codeshelf/KW2CPU.PCB/README.md

KW2CPU.PCB
==========

KW2 radio / CPU PCB design files (with production files). "Brain"
