codeshelf/KW2CPU.PCB/KW2CPU.PCB Design Files/EagleUp/eagleUp_KW2CPU.PCB_board_top.jpg

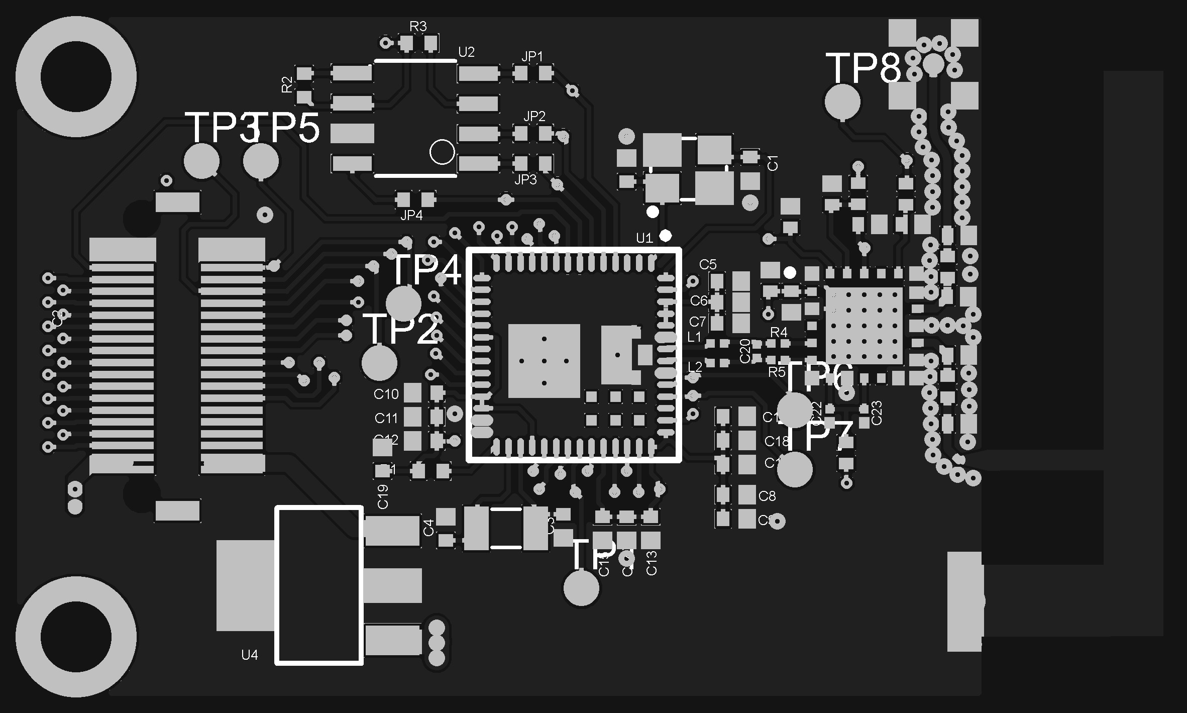
KW2CPU.PCB Design Files/EagleUp/eagleUp_KW2CPU.PCB_board_top.jpg
