codeshelf/KW2CPU.PCB/KW2CPU.PCB Design Files/EagleUp/eagleUp_KW2CPU.PCB_top_mask.png

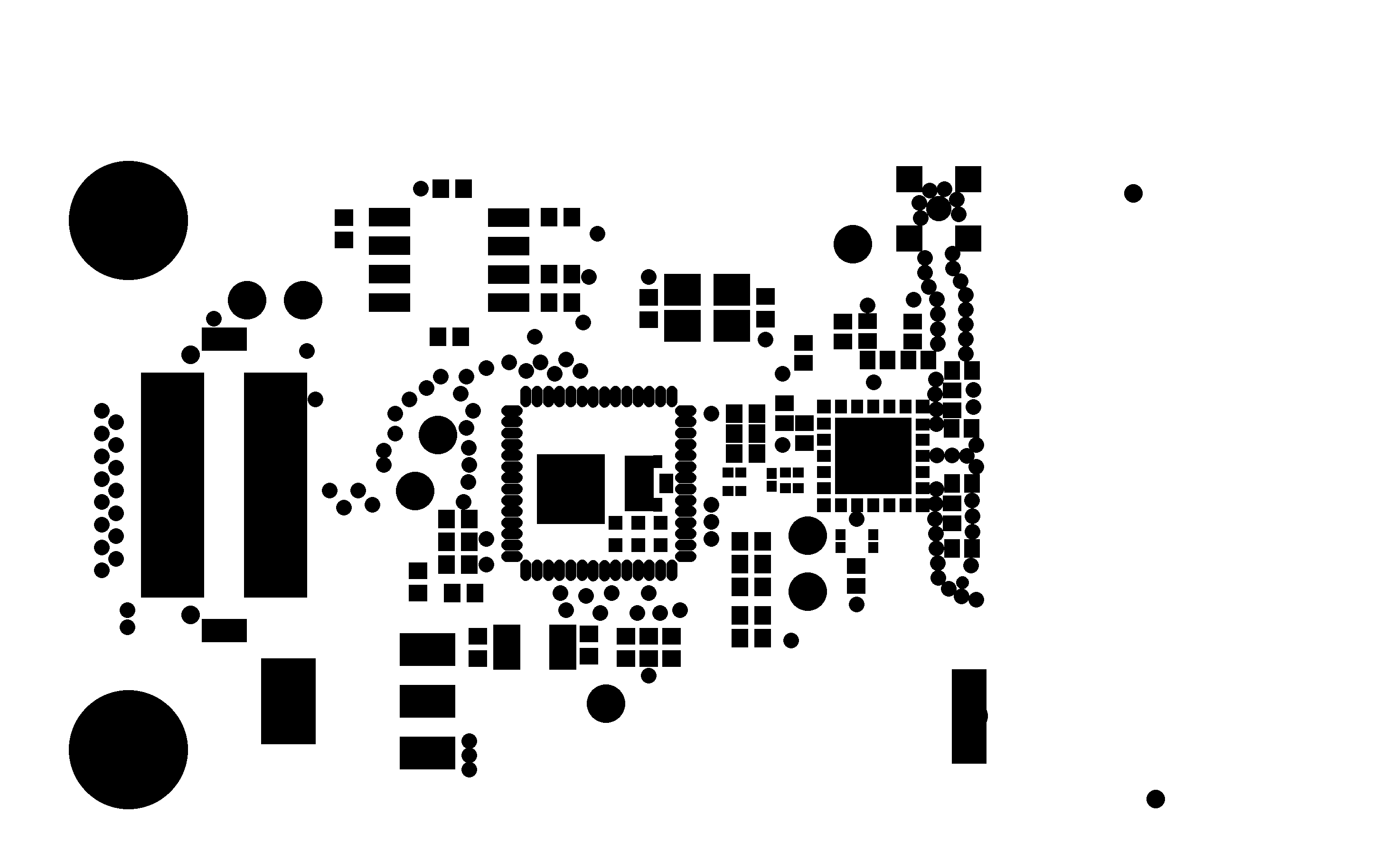
KW2CPU.PCB Design Files/EagleUp/eagleUp_KW2CPU.PCB_top_mask.png
