codeshelf/KW2CPU.PCB/KW2CPU.PCB Design Files/EagleUp/eagleUp_KW2CPU.PCB_top_silk.png

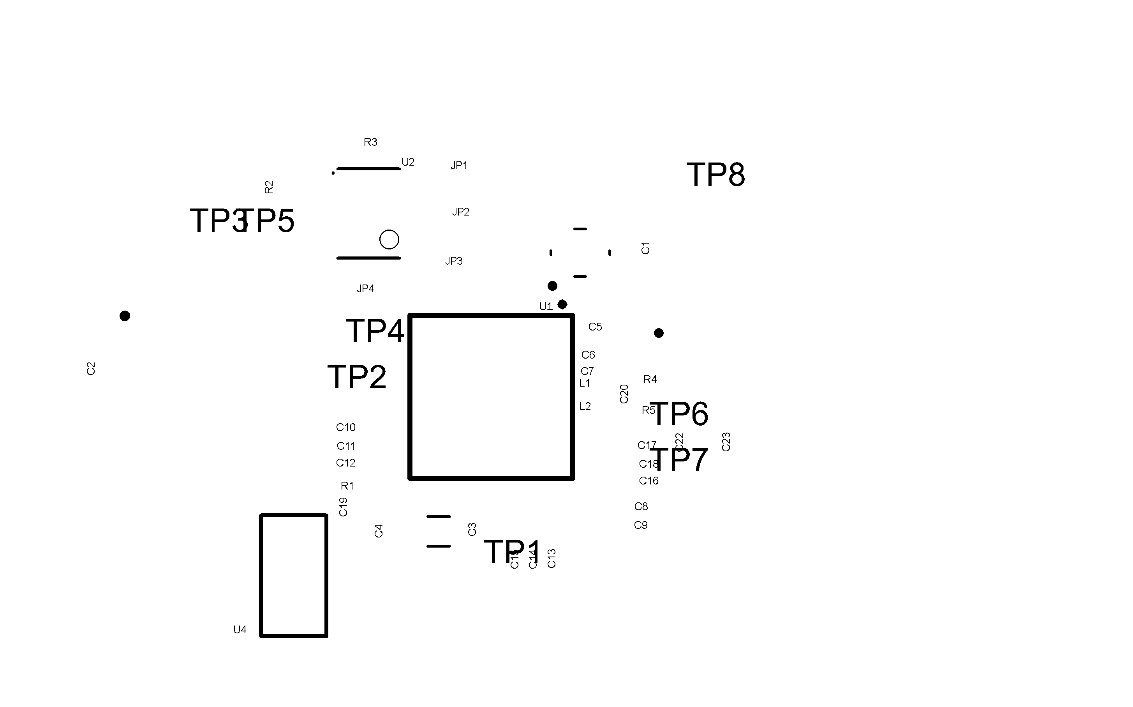
KW2CPU.PCB Design Files/EagleUp/eagleUp_KW2CPU.PCB_top_silk.png
