codeshelf/KW2CPU.PCB/KW2CPU.PCB Design Files/KW2CPU.PCB.dxf

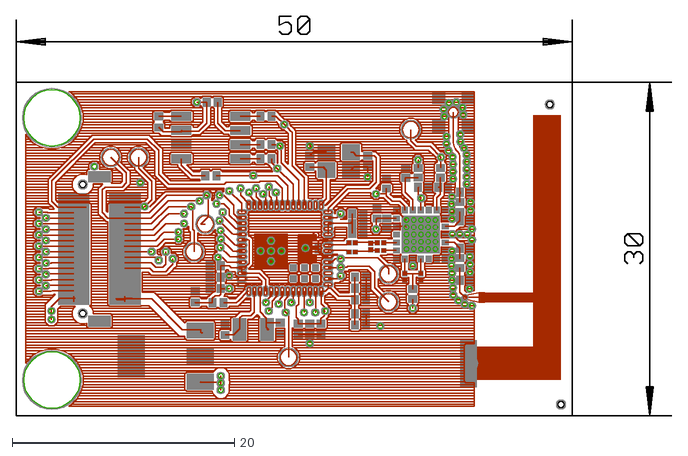
[picture p11: CAD file, 2014-11-19]
KW2CPU.PCB Design Files/KW2CPU.PCB.dxf
59.0 x 35.9
