codeshelf/KW2CPU.PCB/KW2CPU.PCB Design Files/KW2CPU.PCB.brd

## EAGLE design KW2CPU.PCB Design Files/KW2CPU.PCB.brd (2015-08-11)

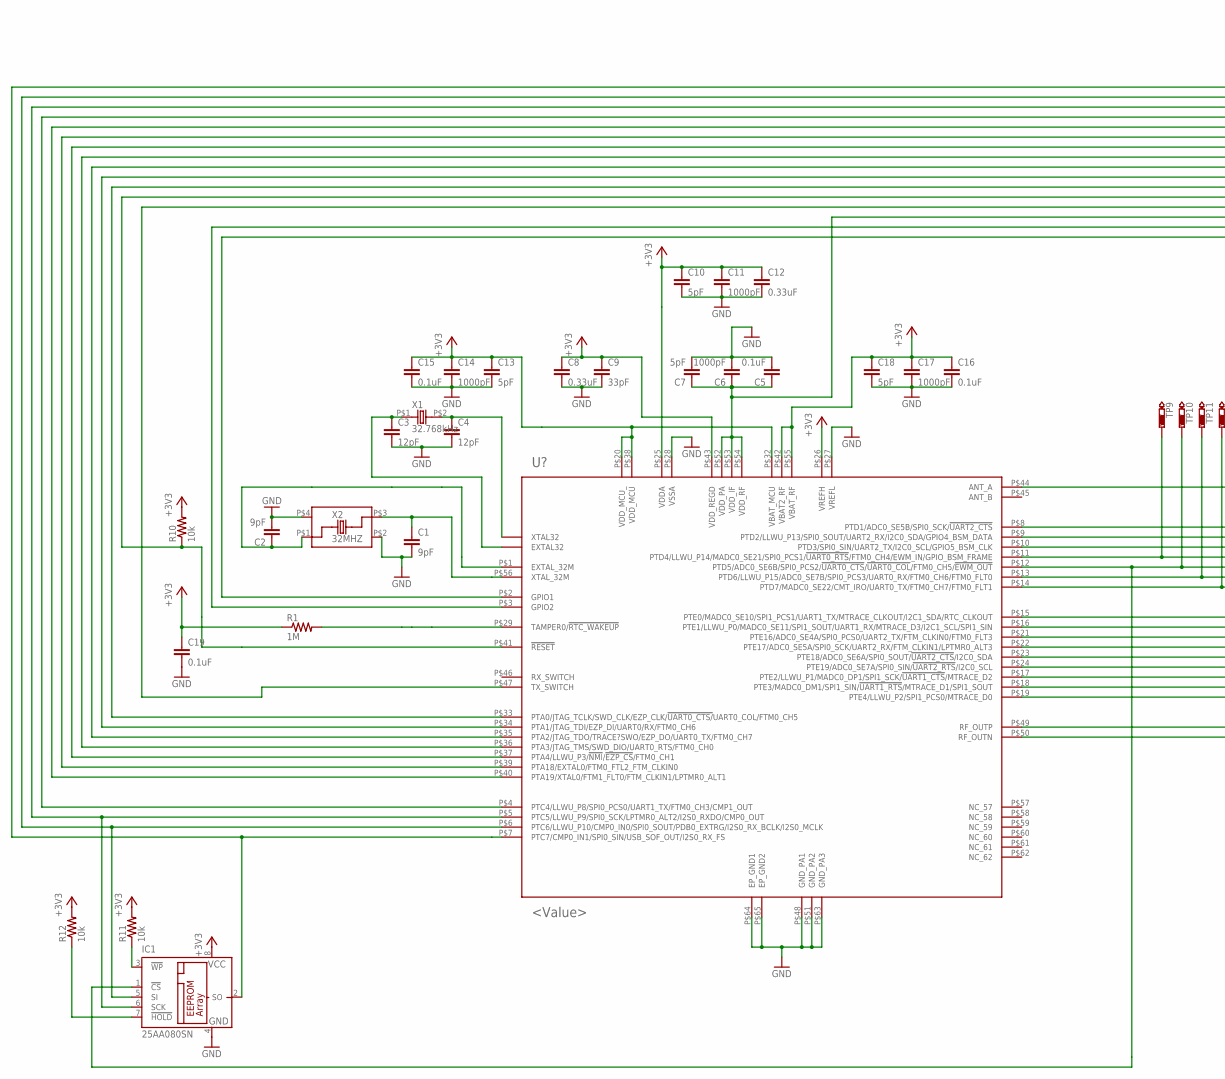
[picture p12: schematic KW2CPU.PCB.sch, part in row 1, column 1]

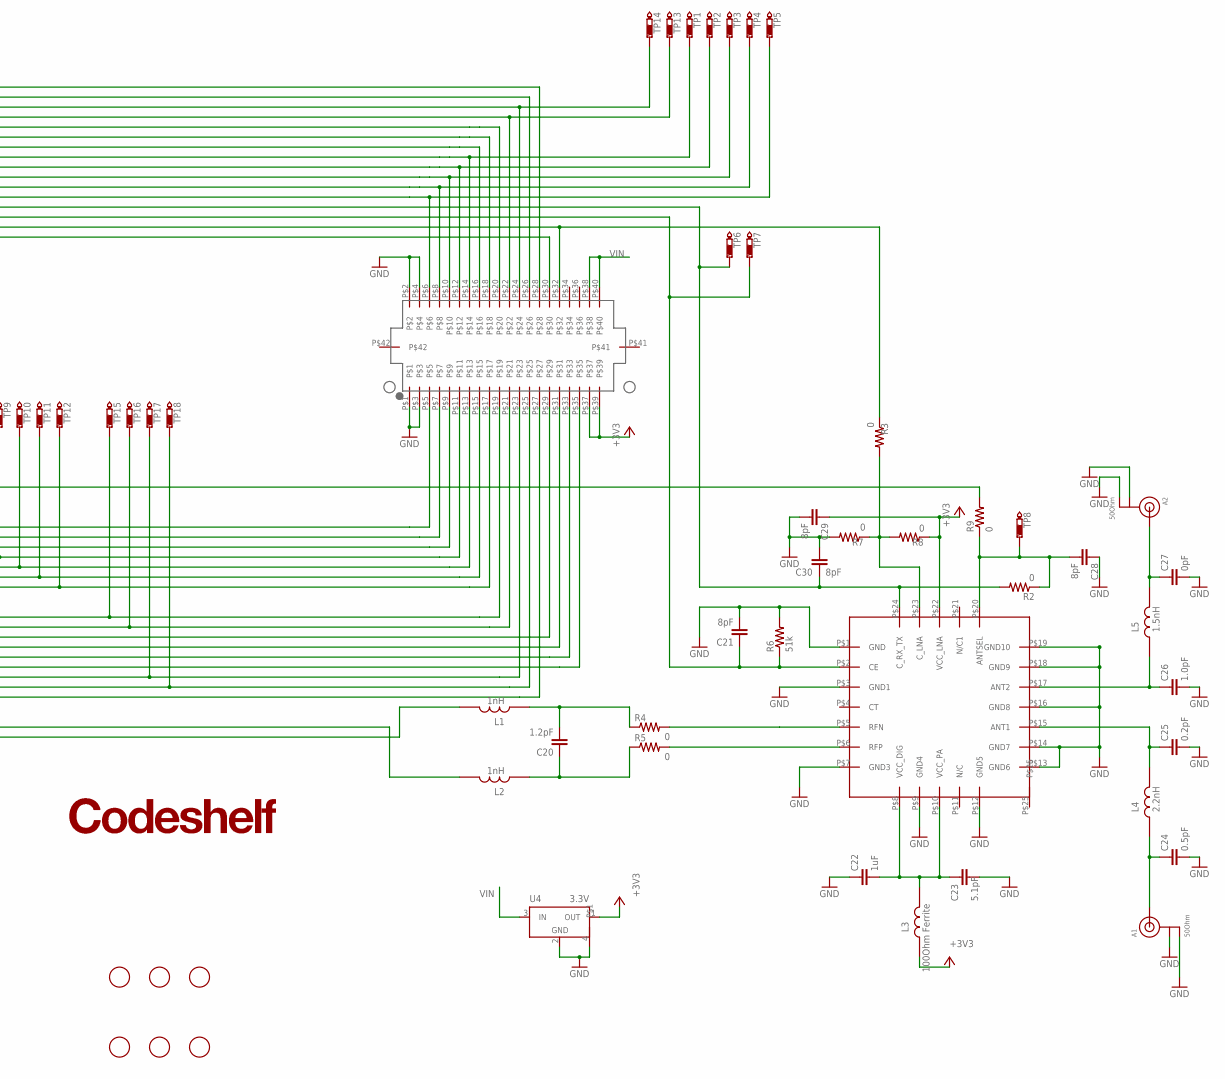
[picture p13: schematic KW2CPU.PCB.sch, part in row 1, column 2]

Parts:
A1, A2: 50Ohm; U.FL
C1, C2: 9pF; C0402
C3, C4: 12pF; C0402
C5, C15, C16, C19: 0.1uF; C0402
C6, C11, C14, C17: 1000pF; C0402
C7, C10, C13, C18: 5pF; C0402
C8, C12: 0.33uF; C0402
C9: 33pF; C0402
C20: 1.2pF; RF-L0201
C21, C28, C29, C30: 8pF; RFMD0402
C22: 1uF; RF-L0201
C23: 5.1pF; RF-L0201
C24: 0.5pF; RFMD0402
C25: 0.2pF; RFMD0402
C26: 1.0pF; RFMD0402
C27: 0pF; RFMD0402
IC1: 25AA080SN; SO-08; MPN 25AA640A
J1: DF12_M
L1, L2: 1nH; RF-L0201
L3: 100Ohm Ferrite; RFMD0402
L4: 2.2nH; RFMD0402
L5: 1.5nH; RFMD0402
R1: 1M; RF-R0402
R2, R3, R7, R8, R9: 0; RFMD0402
R4, R5: 0; RF-L0201
R6: 51k; RFMD0402
R10, R11, R12: 10k; RF-R0402
TP1, TP2, TP3, TP4, TP5, TP6, TP7, TP8, TP9, TP10, TP11, TP12, TP13, TP14, TP15, TP16, TP17, TP18: PTR1TP15R; TP15R
U1: MKW21D; LGA63
U3: RF6555
U4: 3.3V; SOT223
U$1: CODESHELF-LOGOSMALL; CODESHELF-LOGO-SMALL
U$2, U$3, U$4, U$5, U$6, U$7: FIDUCIAL; FIDUCIAL_1MM
X1: 32.768kHz; 32KHZSMD
X2: 32MHZ; 32MHZSMD

Connections:
!HOLD: IC1.7 (!HOLD), R12.1
!RESET: J1.P$6, R10.1, TP5.TP, U1.P$41 (!RESET)
!WP: IC1.3 (!WP), R11.1
+3V3: C8.1, C9.1, C10.1, C11.1, C12.1, C13.1, C14.1, C15.1, C16.1, C17.1, C18.1, C19.1, C29.P$1 (1), IC1.8 (VCC), J1.P$37, J1.P$39, L3.P$2 (2), R1.1, R8.P$1 (1), R10.2, R11.2, R12.2, U1.P$20 (VDD_MCU_), U1.P$25 (VDDA), U1.P$26 (VREFH), U1.P$32 (VBAT_MCU), U1.P$38 (VDD_MCU), U1.P$42 (VBAT2_RF), U1.P$43 (VDD_REGD), U1.P$55 (VBAT_RF), U3.P$22 (VCC_LNA), U4.1 (OUT)
ANT1: C25.P$1 (1), L4.P$1 (1), U3.P$15 (ANT1)
ANT2: C26.P$1 (1), L5.P$2 (2), U3.P$17 (ANT2)
ANTSEL: C28.P$2 (2), R2.P$1 (1), R9.P$1 (1), TP8.TP, U3.P$20 (ANTSEL)
ANT_A: R9.P$2 (2), U1.P$44 (ANT_A)
C_LNA: R3.P$2 (2), R7.P$1 (1), R8.P$2 (2), U3.P$23 (C_LNA)
EXTAL32: C3.1, U1.P$31 (EXTAL32), X1.P$1 (1)
EXTAL_32M: C2.1, U1.P$1 (EXTAL_32M), X2.P$1
GND: A1.1 (GND), A1.2 (GND), A2.1 (GND), A2.2 (GND), C1.2, C2.2, C3.2, C4.2, C5.2, C6.2, C7.2, C8.2, C9.2, C10.2, C11.2, C12.2, C13.2, C14.2, C15.2, C16.2, C17.2, C18.2, C19.2, C21.P$2 (2), C22.P$1 (1), C23.P$2 (2), C24.P$2 (2), C25.P$2 (2), C26.P$2 (2), C27.P$2 (2), C28.P$1 (1), C29.P$2 (2), C30.P$1 (1), IC1.4 (GND), J1.P$1, J1.P$2, J1.P$3, J1.P$4, R6.P$2 (2), R7.P$2 (2), U1.P$27 (VREFL), U1.P$28 (VSSA), U1.P$48 (GND_PA1), U1.P$51 (GND_PA2), U1.P$63 (GND_PA3), U1.P$64 (EP_GND1), U1.P$65 (EP_GND2), U3.P$1 (GND), U3.P$3 (GND1), U3.P$7 (GND3), U3.P$9 (GND4), U3.P$12 (GND5), U3.P$13 (GND6), U3.P$14 (GND7), U3.P$16 (GND8), U3.P$18 (GND9), U3.P$19 (GND10), U4.2 (GND), U4.4, X2.P$2, X2.P$4
GPIO1: J1.P$30, U1.P$2 (GPIO1)
GPIO2: J1.P$32, R3.P$1 (1), U1.P$3 (GPIO2)
PTA0/JTAG_TCLK/SWD_CLK/EZP_CLK/!UART0_CTS/!UART0_COL/FTM0_CH5: J1.P$8, TP4.TP, U1.P$33 (PTA0/JTAG_TCLK/SWD_CLK/EZP_CLK/!UART0_C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)
PTA1/JTAG_TDI/EZP_DI/UART0/RX/FTM0_CH6: J1.P$10, TP3.TP, U1.P$34 (PTA1/JTAG_TDI/EZP_DI/UART0/RX/FTM0_CH6)
PTA2/JTAG_TDO/TRACE?SWO/EZP_DO/UART0_TX/FTM0_CH7: J1.P$12, TP2.TP, U1.P$35 (PTA2/JTAG_TDO/TRACE?SWO/EZP_DO/UART0_TX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)
PTA3/JTAG_TMS/SWD_DIO/UART0_RTS/FTM0_CH0: J1.P$14, TP1.TP, U1.P$36 (PTA3/JTAG_TMS/SWD_DIO/UART0_RTS/FTM0_CH0)
PTA4/LLWU_P3/!NMI!/!EZP_CS!/FTM0_CH1: J1.P$16, U1.P$37 (PTA4/LLWU_P3/!NMI!/!EZP_CS!/FTM0_CH1)
PTA18/EXTAL0/FTM0_FTL2_FTM_CLKIN0: J1.P$18, U1.P$39 (PTA18/EXTAL0/FTM0_FTL2_FTM_CLKIN0)
PTA19/XTAL0/FTM1_FLT0/FTM_CLKIN1/LPTMR0_ALT1: J1.P$20, U1.P$40 (PTA19/XTAL0/FTM1_FLT0/FTM_CLKIN1/LPTMR0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)
PTC4/LLWU_P8/SPI0_PCS0/UART1_TX/FTM0_CH3/CMP1_OUT: J1.P$22, TP13.TP, U1.P$4 (PTC4/LLWU_P8/SPI0_PCS0/UART1_TX/FTM0_CH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)
PTC5/LLWU_P9/SPI0_SCK/LPTMR0_ALT2/I2S0_RXDO/CMP0_OUT: IC1.6 (SCK), J1.P$24, TP14.TP, U1.P$5 (PTC5/LLWU_P9/SPI0_SCK/LPTMR0_ALT2/I2S0_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)
PTC6/LLWU_P10/CMP0_IN0/SPI0_SOUT/PDB0_EXTRG/I2S0_RX_BCLK/I2S0_MCLK: IC1.5 (SI), J1.P$26, U1.P$6 (PTC6/LLWU_P10/CMP0_IN0/SPI0_SOUT/PDB0_E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)
PTC7/CMP0_IN1/SPI0_SIN/USB_SOF_OUT/I2S0_RX_FS: IC1.2 (SO), J1.P$28, U1.P$7 (PTC7/CMP0_IN1/SPI0_SIN/USB_SOF_OUT/I2S0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)
PTD1/ADC0_SE5B/SPI0_SCK/!UART2_CTS: J1.P$5, U1.P$8 (PTD1/ADC0_SE5B/SPI0_SCK/!UART2_CTS)
PTD2/LLWU_P13/SPI0_SOUT/UART2_RX/I2C0_SDA/GPIO4_BSM_DATA: J1.P$7, U1.P$9 (PTD2/LLWU_P13/SPI0_SOUT/UART2_RX/I2C0_S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)
PTD3/SPI0_SIN/UART2_TX/I2C0_SCL/GPIO5_BSM_CLK: J1.P$9, U1.P$10 (PTD3/SPI0_SIN/UART2_TX/I2C0_SCL/GPIO5_B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)
PTD4/LLWU_P14/MADC0_SE21/SPI0_PCS1/!UART0_RTS!/FTM0_CH4/EWM_IN/GPIO_BSM_FRAME: J1.P$11, TP9.TP, U1.P$11 (PTD4/LLWU_P14/MADC0_SE21/SPI0_PCS1/!UAR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)
PTD5/ADC0_SE6B/SPI0_PCS2/!UART0_CTS!/!UART0_COL!/FTM0_CH5/!EWM_OUT: IC1.1 (!CS), J1.P$13, TP10.TP, U1.P$12 (PTD5/ADC0_SE6B/SPI0_PCS2/!UART0_CTS!/!U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)
PTD6/LLWU_P15/ADC0_SE7B/SPI0_PCS3/UART0_RX/FTM0_CH6/FTM0_FLT0: J1.P$15, TP11.TP, U1.P$13 (PTD6/LLWU_P15/ADC0_SE7B/SPI0_PCS3/UART0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)
PTD7/MADC0_SE22/CMT_IRO/UART0_TX/FTM0_CH7/FTM0_FLT1: J1.P$17, TP12.TP, U1.P$14 (PTD7/MADC0_SE22/CMT_IRO/UART0_TX/FTM0_C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)
PTE0/MADC0_SE10/SPI1_PCS1/UART1_TX/MTRACE_CLKOUT/I2C1_SDA/RTC_CLKOUT: J1.P$19, TP15.TP, U1.P$15 (PTE0/MADC0_SE10/SPI1_PCS1/UART1_TX/MTRA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)
PTE1/LLWU_P0/MADC0_SE11/SPI1_SOUT/UART1_RX/MTRACE_D3/I2C1_SCL/SPI1_SIN: J1.P$21, TP16.TP, U1.P$16 (PTE1/LLWU_P0/MADC0_SE11/SPI1_SOUT/UART1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)
PTE2/LLWU_P1/MADC0_DP1/SPI1_SCK/!UART1_CTS!/MTRACE_D2: J1.P$23, TP17.TP, U1.P$17 (PTE2/LLWU_P1/MADC0_DP1/SPI1_SCK/!UART1_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)
PTE3/MADC0_DM1/SPI1_SIN/!UART1_RTS!/MTRACE_D1/SPI1_SOUT: J1.P$25, TP18.TP, U1.P$18 (PTE3/MADC0_DM1/SPI1_SIN/!UART1_RTS!/MTR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)
PTE4/LLWU_P2/SPI1_PCS0/MTRACE_D0: J1.P$27, U1.P$19 (PTE4/LLWU_P2/SPI1_PCS0/MTRACE_D0)
PTE16/ADC0_SE4A/SPI0_PCS0/UART2_TX/FTM_CLKIN0/FTM0_FLT3: J1.P$29, U1.P$21 (PTE16/ADC0_SE4A/SPI0_PCS0/UART2_TX/FTM_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)
PTE17/ADC0_SE5A/SPI0_SCK/UART2_RX/FTM_CLKIN1/LPTMR0_ALT3: J1.P$31, U1.P$22 (PTE17/ADC0_SE5A/SPI0_SCK/UART2_RX/FTM_C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)
PTE18/ADC0_SE6A/SPI0_SOUT/!UART2_CTS!/I2C0_SDA: J1.P$33, U1.P$23 (PTE18/ADC0_SE6A/SPI0_SOUT/!UART2_CTS!/I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)
PTE19/ADC0_SE7A/SPI0_SIN/!UART2_RTS!/I2C0_SCL: J1.P$35, U1.P$24 (PTE19/ADC0_SE7A/SPI0_SIN/!UART2_RTS!/I2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)
RADIO_AREG: C5.1, C6.1, C7.1, C21.P$1 (1), R6.P$1 (1), TP7.TP, U1.P$52 (VDD_PA), U1.P$53 (VDD_IF), U1.P$54 (VDD_RF), U3.P$2 (CE)
RFN: R4.P$2 (2), U3.P$5 (RFN)
RFN_MATCH: C20.P$2 (2), L1.P$2 (2), R4.P$1 (1)
RFP: R5.P$2 (2), U3.P$6 (RFP)
RFP_MATCH: C20.P$1 (1), L2.P$2 (2), R5.P$1 (1)
RF_OUTN: L1.P$1 (1), U1.P$50 (RF_OUTN)
RF_OUTP: L2.P$1 (1), U1.P$49 (RF_OUTP)
TAMPER/!RTC_WAKEUP: R1.2, U1.P$29 (TAMPER0/!RTC_WAKEUP)
TX_SWITCH: C30.P$2 (2), R2.P$2 (2), TP6.TP, U1.P$47 (TX_SWITCH), U3.P$24 (C_RX_TX)
U.FL.ANT1: A1.3 (SIGNAL), C24.P$1 (1), L4.P$2 (2)
U.FL.ANT2: A2.3 (SIGNAL), C27.P$1 (1), L5.P$1 (1)
VCC_DIG_PA: C22.P$2 (2), C23.P$1 (1), L3.P$1 (1), U3.P$8 (VCC_DIG), U3.P$10 (VCC_PA)
VIN: J1.P$38, J1.P$40, U4.3 (IN)
XTAL32: C4.1, U1.P$30 (XTAL32), X1.P$2 (2)
XTAL_32M: C1.1, U1.P$56 (XTAL_32M), X2.P$3

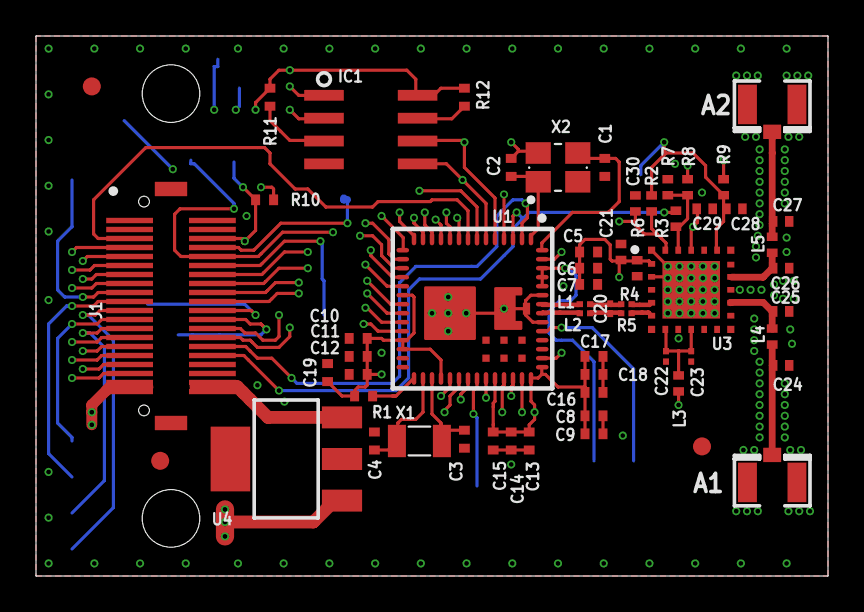
[picture p14: board KW2CPU.PCB.brd from above]

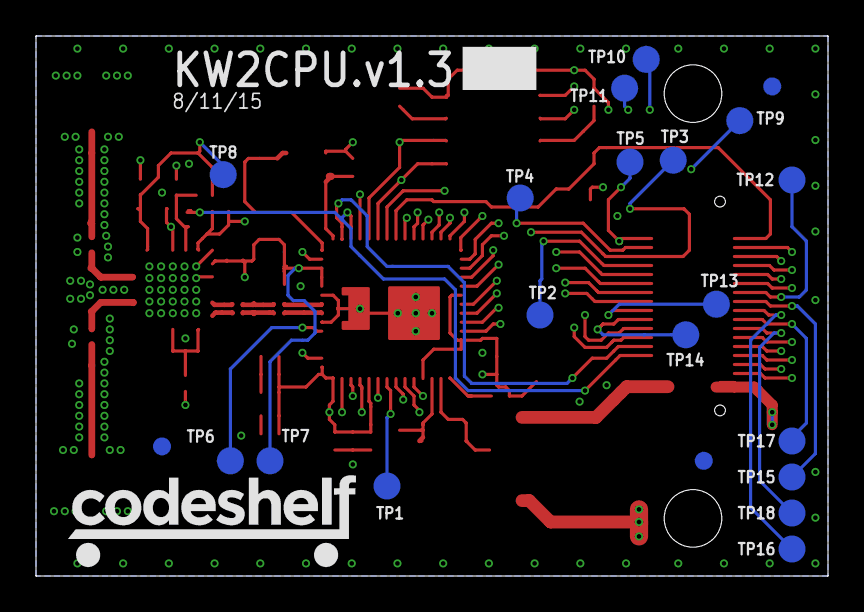
[picture p15: board KW2CPU.PCB.brd from below]

Board: 4 copper layers, 44.0 x 30.0 mm, 81 parts (22 on the bottom side), 56 nets.
