codeshelf/KW2CPU.PCB/(commit log)

2014-10-12 Imported KW2CPU design files
    Imported from Archive repo and deleted that one
    [KW2CPU.PCB.brd, KW2CPU.PCB.sch]
2014-10-13 Working on layout
    ...4 layers is kind of annoying.
    [KW2CPU.PCB.brd, KW2CPU.PCB.sch]
2014-10-18 Added JTAG
    Topside connector. Still needs routing
    [KW2CPU.PCB.brd, KW2CPU.PCB.sch]
2014-10-21 JTAG, RF Conn trace
    Added JTAG connector, adjusted arcs on RF connector trace and added GND
    vias
    [KW2CPU.PCB.brd, KW2CPU.PCB.sch]
2014-10-22 Random things
    Mostly playing with copper settings. No design changes
    [KW2CPU.PCB.brd]
2014-10-31 Rotated board
    [JTAG.brd, JTAG.sch, KW2CPU.PCB.brd, KW2CPU.PCB.sch]
2014-11-05 Schematic fix
    Almost done fixing schematic
    [KW2CPU.PCB.brd, KW2CPU.PCB.sch]
2014-11-07 Added hacky JTAG board
    Terrible angles, but fininshed. Can be made in house (0.2mm)
    [JTAG.brd, KW2CPU.PCB.brd]
2014-11-12 Labeled all nets
    Named nets and simplified JTAG adapter board.
    [JTAG.brd, KW2CPU.PCB.brd, KW2CPU.PCB.sch]
2014-11-13 Fixed RefDes, issues with names disappearing
    Names on layout disappearing (for RF front end parts)
    [KW2CPU.PCB.brd, KW2CPU.PCB.sch]
2014-11-14 Added test points
    JTAG and front-end control test points
    [KW2CPU.PCB.brd, KW2CPU.PCB.sch]
2014-11-19 Added timing TPs
    For radio calibration. Also exported CAD model
    [KW2CPU.PCB.brd, KW2CPU.PCB.dxf, KW2CPU.PCB.sch]
2014-11-19 Fixed PTC5 label and added RESET pullup
    [KW2CPU.PCB.brd, KW2CPU.PCB.sch]
2014-11-20 Switched Flash for EEPROM
    [KW2CPU.PCB.brd, KW2CPU.PCB.sch]
2014-11-22 Added part numbers and manufacturers (inconsistent)
    Also moved files to proper directories. Needs manual inconsistency
    fixing
    [JTAG.brd, JTAG.sch, KW2CPU.PCB.BOM.csv, KW2CPU.PCB.BOM.xlsx, KW2CPU.PCB.brd, KW2CPU.PCB.dxf, KW2CPU.PCB.sch]
2014-11-22 Exporting production files in progress
    Creating production files. Missing: ECO, Stackup, Drill
    [KW2CPU.PCB.BOM.csv, KW2CPU.PCB.BOM.xlsx, KW2CPU.PCB.CENTROID.csv, KW2CPU.PCB.brd, KW2CPU.PCB.sch]
2014-11-22 KW2CPU.PCB.v.1.0 First Article Release
    Added drill file, ECO and FAB notes.
    [KW2CPU.PCB.ECO.xlsx]
2014-11-22 KW2CPU.PCB.v1.0
    Fixed name decimal point
    [KW2CPU.PCB.ECO.xlsx]
2014-12-16 Fixed Vreg part #, changed JTAG holes
    Added /DB suffix to VReg and reexported BOM (identify package), fixed
    JTAG holes (try square). No design changes in BRAIN, just layer view
    options.
    [JTAG.brd, JTAG.sch, KW2CPU.PCB.BOM.csv, KW2CPU.PCB.BOM.xlsx, KW2CPU.PCB.brd]
2014-12-20 KW2CPU.PCB.v1.1 Release
    Fixed Gerbers (omitted layer), fixed BOM suffixes (see ECO), tented vias
    and antenna holes in Eagle (and Gerbers), added Stackup -> Layer in Fab
    notes.
    [KW2CPU.PCB.BOM.xlsx, KW2CPU.PCB.ECO.xlsx, KW2CPU.PCB.brd, KW2CPU.PCB.csv, KW2CPU.PCB.sch, KW2CPU.PCB.xlsx, KW2CPU.PCB_centroid.csv]
2015-01-16 Fixed PTC5 net name
    [KW2CPU.PCB.brd, KW2CPU.PCB.sch]
2015-02-07 KW2CPU.PCB.v1.2 Release
    DNP Voltage regulator (BOM change + schematic attribute, ECO),
    incremented silkscreen to v1.2, fixed name on BOM filr (added .BOM)
    [KW2CPU.PCB.BOM.csv, KW2CPU.PCB.BOM.xlsx, KW2CPU.PCB.ECO.xlsx, KW2CPU.PCB.brd, KW2CPU.PCB.sch, KW2CPU.PCB.xlsx]
2015-05-20 First cut at v1.3 (antenna diversity)
    * Antenna diversity
    * ISO layouts
    * More TPs
    * Axial anchors
    * Remvoe top JTAG connector
    [KW2CPU.PCB.brd, KW2CPU.PCB.sch]
2015-06-11 Layout changes
    [KW2CPU.PCB.brd]
2015-07-01 KW2 v1.3 revisions
    The first big slug of KW2 revisions.
    [KW2CPU.PCB.brd, KW2CPU.PCB.sch]
2015-07-01 Fix RF6555
    Align the GND vias
    [KW2CPU.PCB.brd]
2015-07-24 Fixes after Rafael's review
    * DNP all but the dedicated RX/TX antenna select option via GPIO2.
    * DNP all but the LNA passthrough control option.
    [KW2CPU.PCB.brd, KW2CPU.PCB.sch]
2015-07-24 Connect RF6555 CE to KW2 AREG
    [KW2CPU.PCB.brd, KW2CPU.PCB.sch]
2015-07-29 Impedance ajustments
    Also removed old production files. Adjusted differential pair and
    single-ended traces.
    [KW2CPU.PCB.BOM.csv, KW2CPU.PCB.BOM.xlsx, KW2CPU.PCB.ECO.xlsx, KW2CPU.PCB.sch, KW2CPU.PCB_centroid.csv]
2015-07-29 Fixed grid units, adjusted vias
    Moved and adjusted all GND vias near RF traces
    [KW2CPU.PCB.brd]
2015-07-31 Updated traces for impedance
    As per RoyalCircuits recommendation
    [KW2CPU.PCB.brd, KW2CPU.PCB.sch]
2015-08-05 Minor adjustments (silkscreen, DNPs)
    Added silkscren RefDes for antenna connectors, RFMD and Hirose
    connector. Added PN for antenna connector, DNP for match neworks and
    re-exported CSV BOM
    [KW2CPU.PCB.BOM.csv, KW2CPU.PCB.brd, KW2CPU.PCB.sch]
2015-08-07 KW2CPU.PCB.v1.3P1
    Design and production files for new KW2
    [KW2CPU.PCB.BOM.csv, KW2CPU.PCB.BOM.xlsx, KW2CPU.PCB.ECO.xlsx, KW2CPU.PCB.brd, KW2CPU.PCB.sch]
2015-08-11 KW2CPU.PCB.v1.3P1 (Revision)
    Added GND strips + vias for RF foam, fixed silkscreen, moved regulator
    to accomodate new hole position (from before) and removed vias under
    KW2. New production files sent to Calla for quoting / prototype run
    [KW2CPU.PCB.BOM.csv, KW2CPU.PCB.BOM.xlsx, KW2CPU.PCB.ECO.xlsx, KW2CPU.PCB.sch, KW2CPU.PCB_centroid.csv]
2015-08-11 Omitted brd file from commit
    [KW2CPU.PCB.brd]
